Michi-Tsubaki/ping-pong-robot/docs/report/presentation/slide.pdf

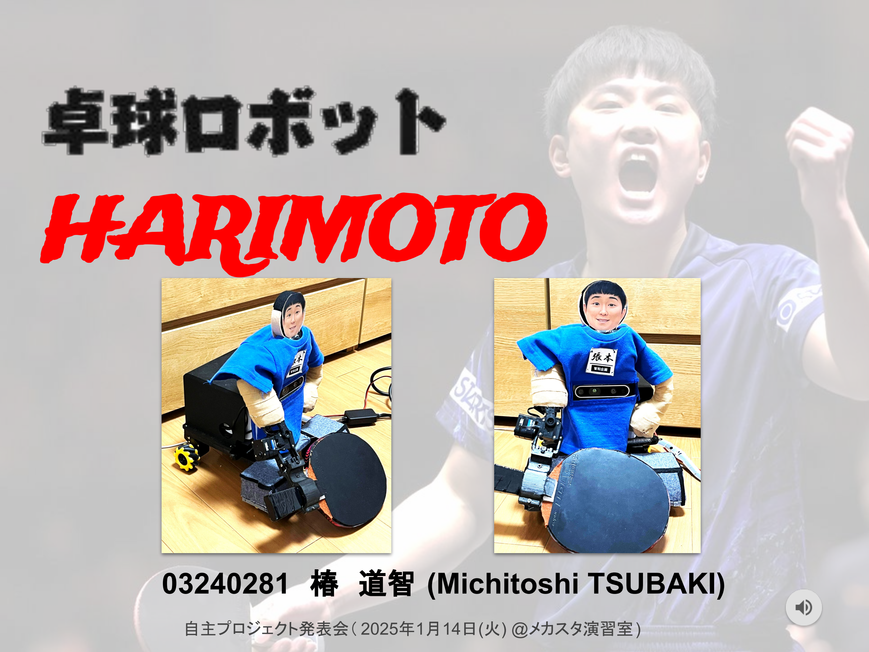
[picture p1: page 1]

# 03240281 椿 道智 (Michitoshi TSUBAKI)

自主プロジェクト発表会（ 2025年1月14日(火) @メカスタ演習室)

# HARIMOTO

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

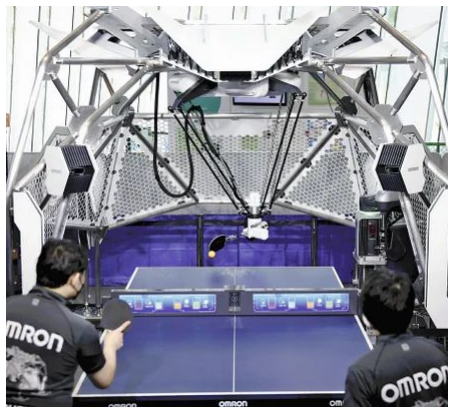
[picture p2: figure]
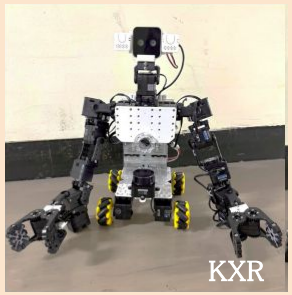
[picture p3: figure]
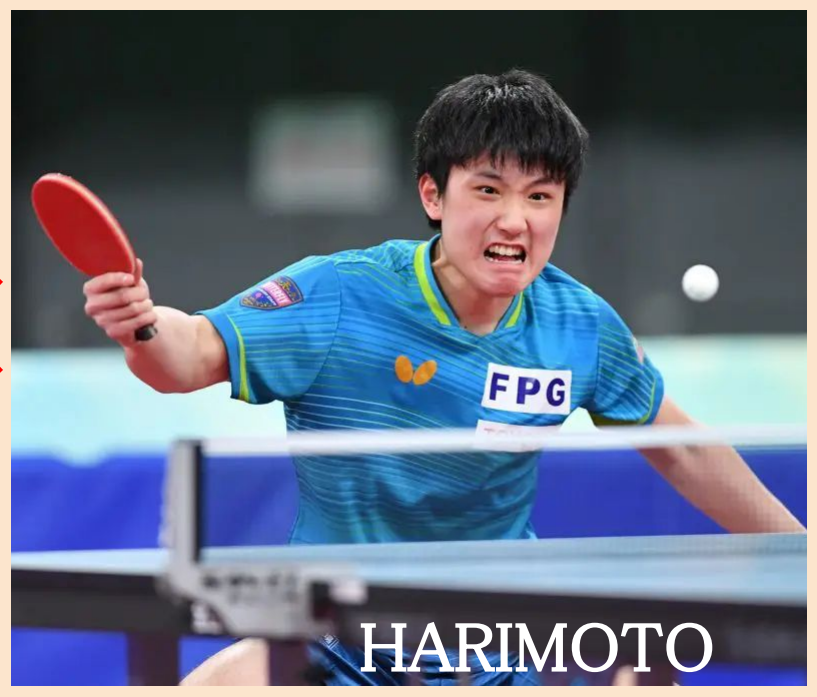
[picture p4: figure]

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

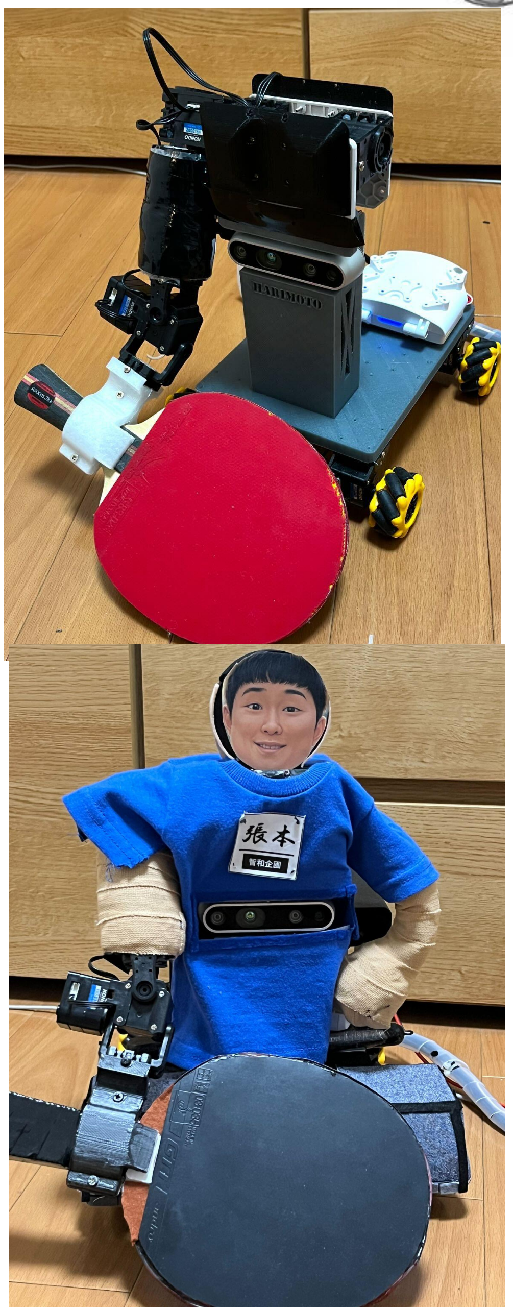
[picture p5: figure]

# システム構成図

# 画像処理

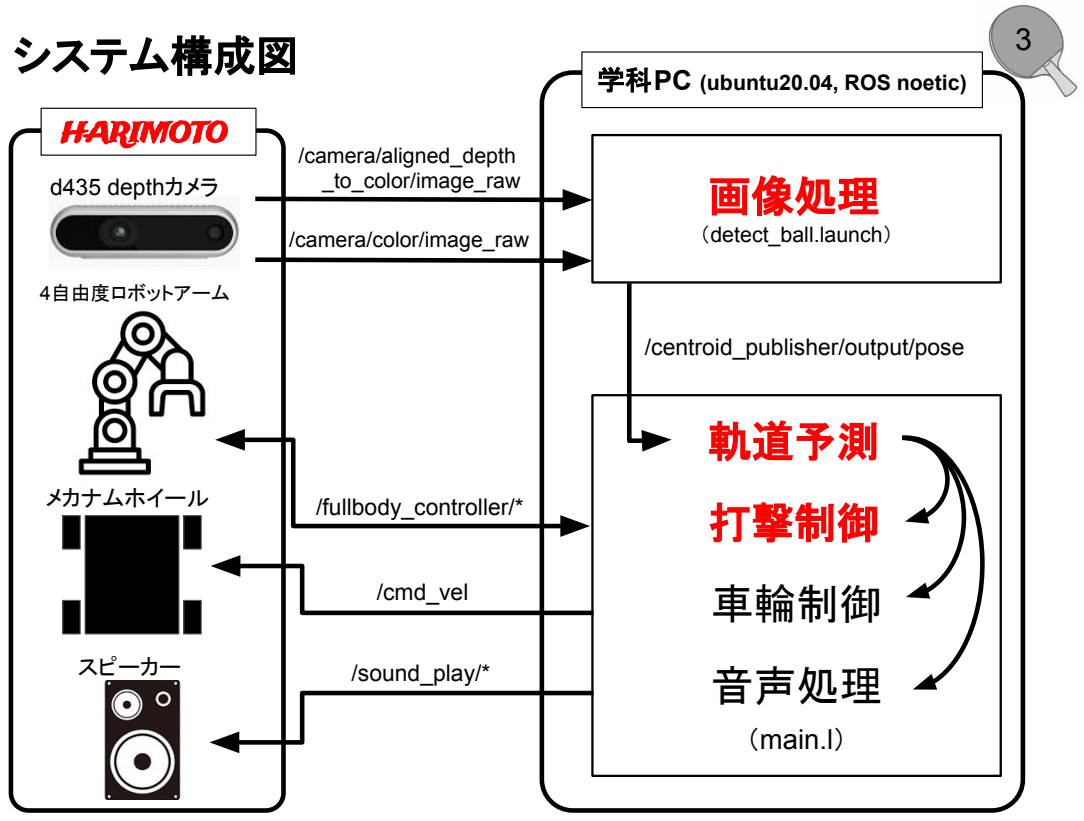
[picture p6: page 4]
（detect_ball.launch）; 軌道予測; 打撃制御; 車輪制御; 音声処理; （main.l）; d435 depthカメラ; /centroid_publisher/output/pose; スピーカー; メカナムホイール; 4自由度ロボットアーム; /cmd_vel; HARIMOTO; /camera/color/image_raw; /camera/aligned_depth _to_color/image_raw; /sound_play/*; /fullbody_controller/*

学科PC (ubuntu20.04, ROS noetic)

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
