Michi-Tsubaki/ping-pong-robot/model/figure/arm_1.png

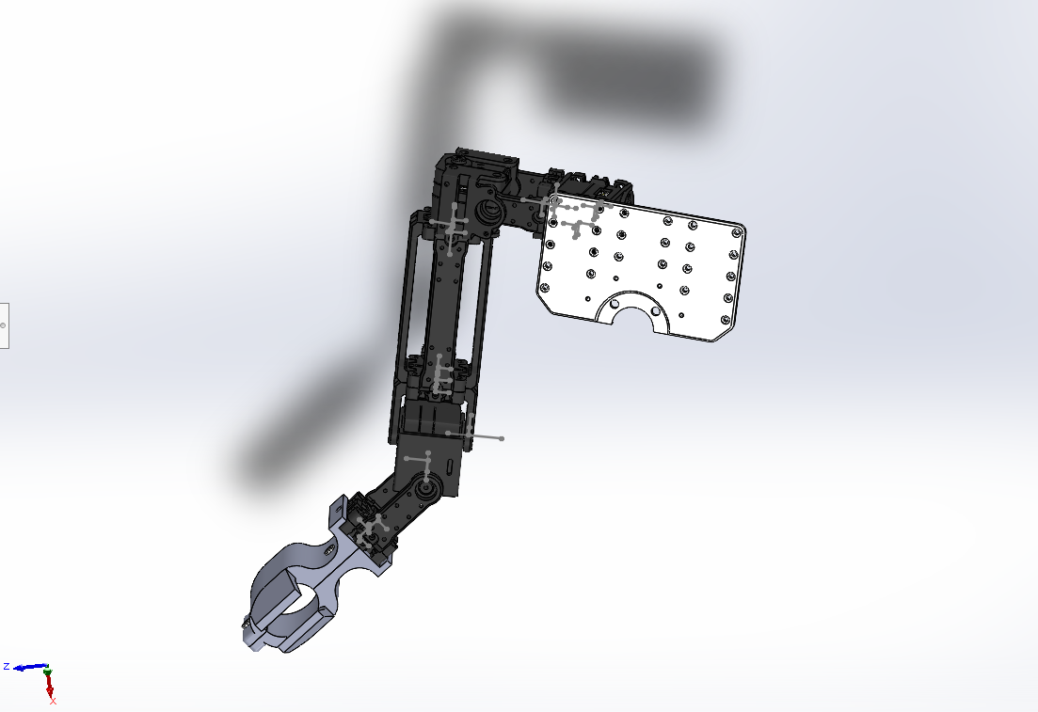
model/figure/arm_1.png
