Michi-Tsubaki/ping-pong-robot/model/figure/arm_skelton_1.png

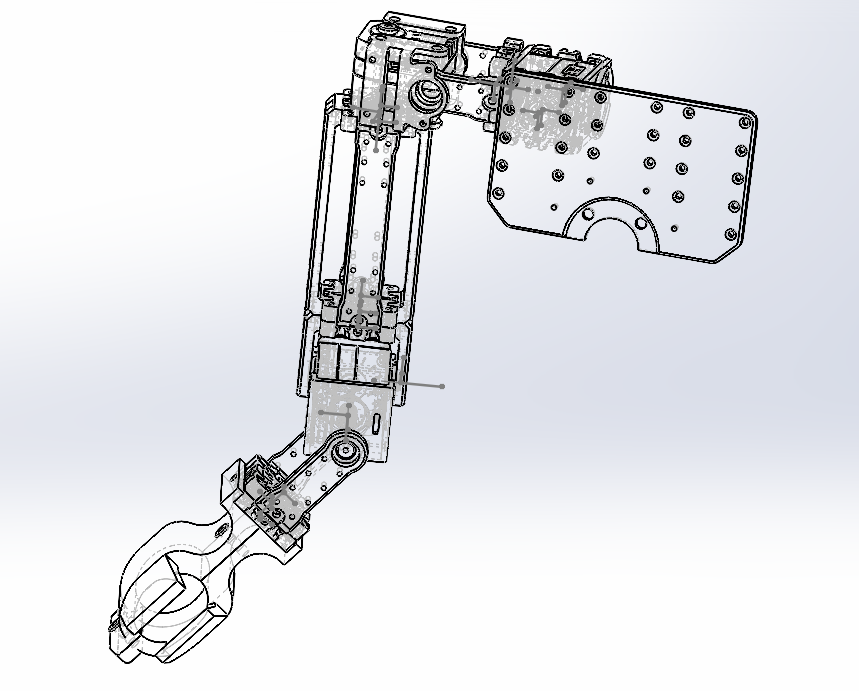
model/figure/arm_skelton_1.png
