Michi-Tsubaki/ping-pong-robot/model/assembly/base.SLDASM

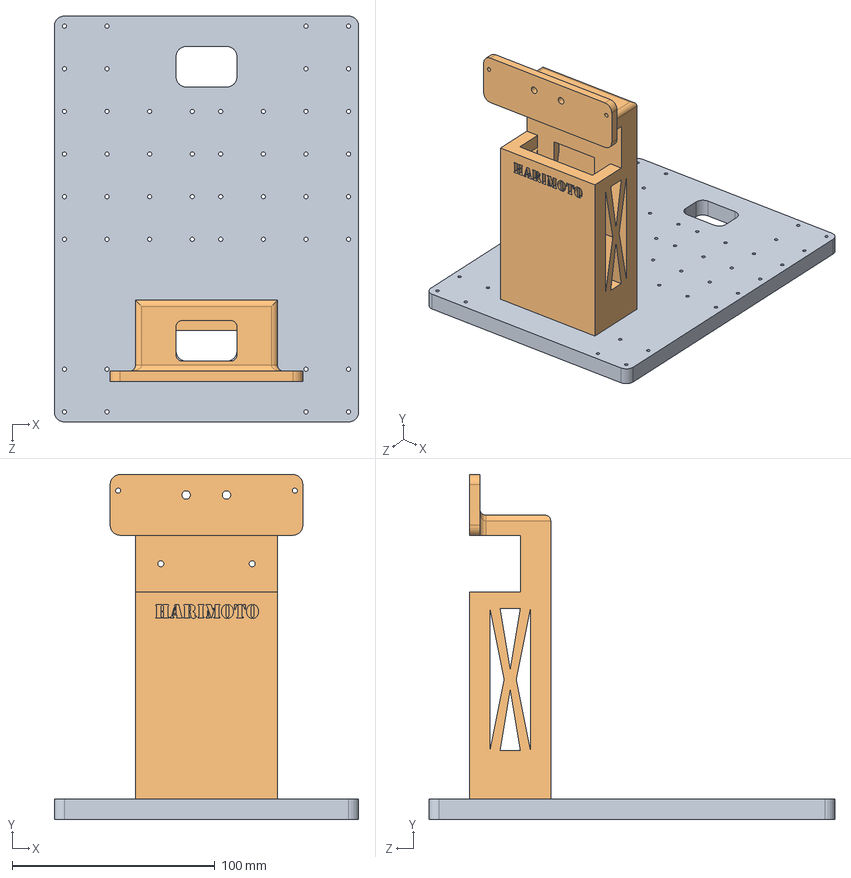
[picture p18: CAD file, 2025-05-12]
model/assembly/base.SLDASM
150.0 x 170.0 x 200.0 mm
body_base
wheel_base
