Michi-Tsubaki/ping-pong-robot/meshes/lower_shoulder.STL

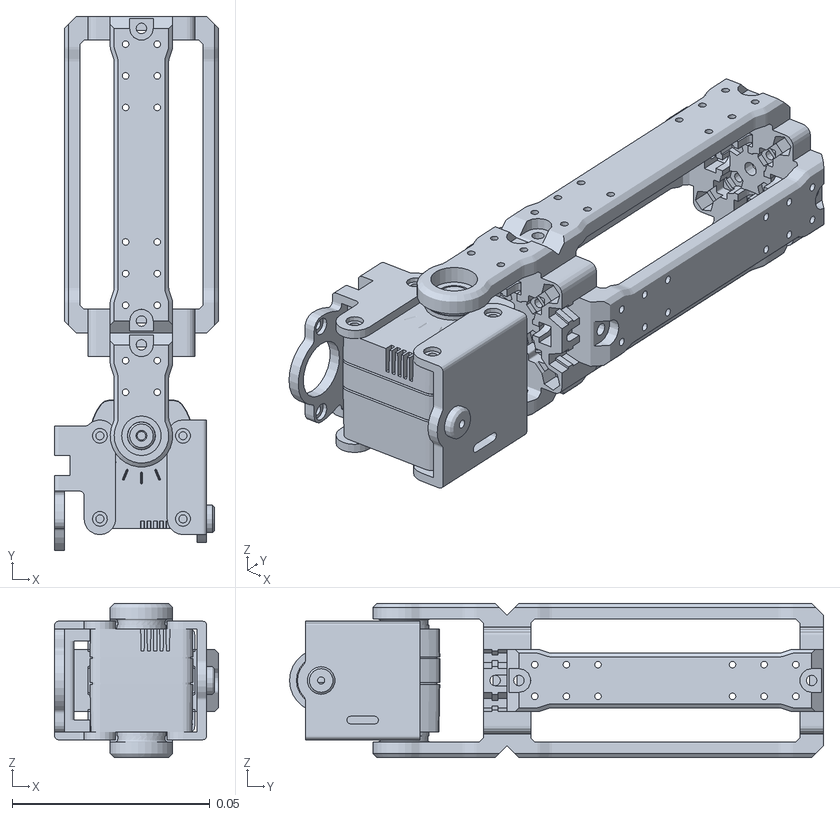
[picture p19: CAD file, 2025-05-12]
meshes/lower_shoulder.STL
0.0415 x 0.135 x 0.039
