Michi-Tsubaki/ping-pong-robot/model/figure/body_panel_cut3.DXF

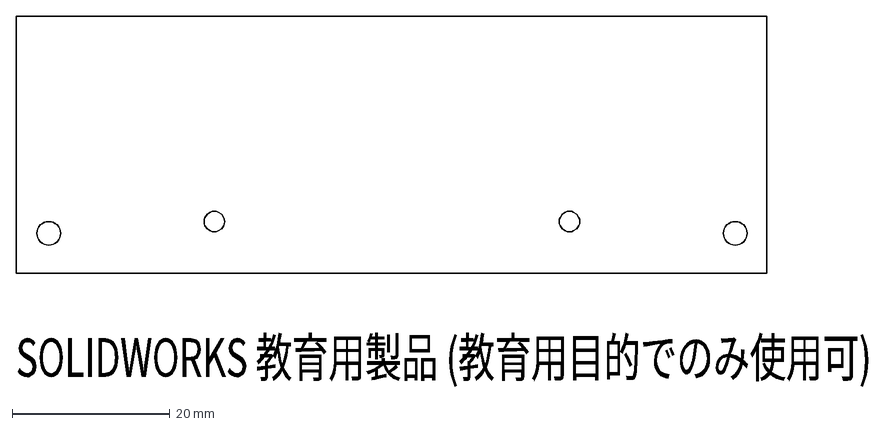
[picture p20: CAD file, 2025-05-12]
model/figure/body_panel_cut3.DXF
SOLIDWORKS 教育用製品 (教育用目的でのみ使用可)
