Michi-Tsubaki/ping-pong-robot/model/parts/sldprt/wheel_base.SLDPRT

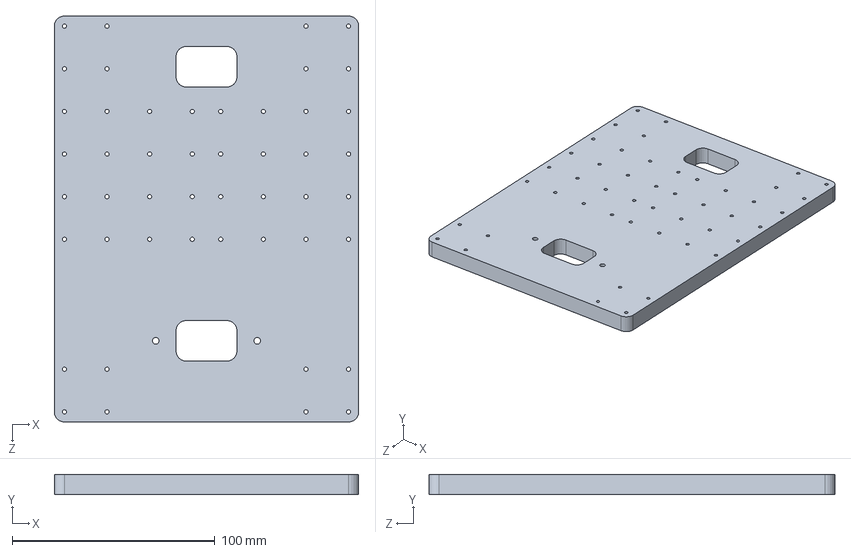
[picture p21: CAD file, 2025-05-12]
model/parts/sldprt/wheel_base.SLDPRT
150.0 x 10.0 x 200.0 mm
