Michi-Tsubaki/ping-pong-robot/model/parts/stl/body_panel_cut3.STL

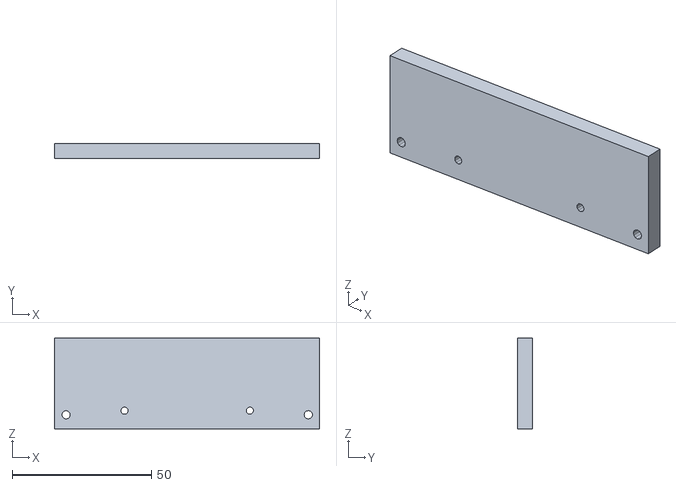
[picture p22: CAD file, 2025-05-12]
model/parts/stl/body_panel_cut3.STL
95.1 x 5.50 x 32.6
