Michi-Tsubaki/ping-pong-robot/meshes/larm_link7.stl

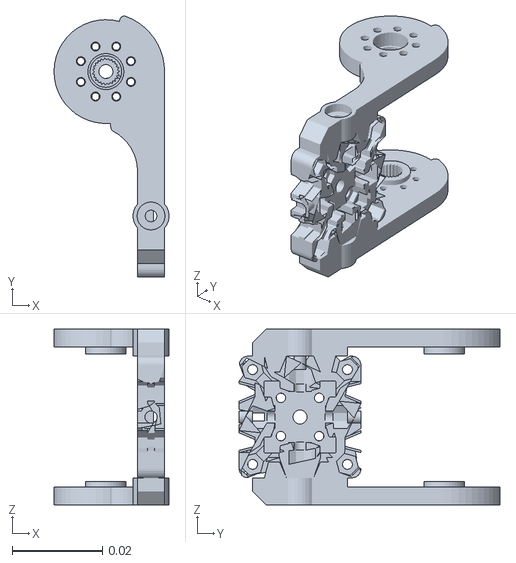
[picture p23: CAD file, 2025-05-12]
meshes/larm_link7.stl
0.0255 x 0.0578 x 0.039
