Michi-Tsubaki/ping-pong-robot/model/parts/sldprt/racket_holeder_2.SLDPRT

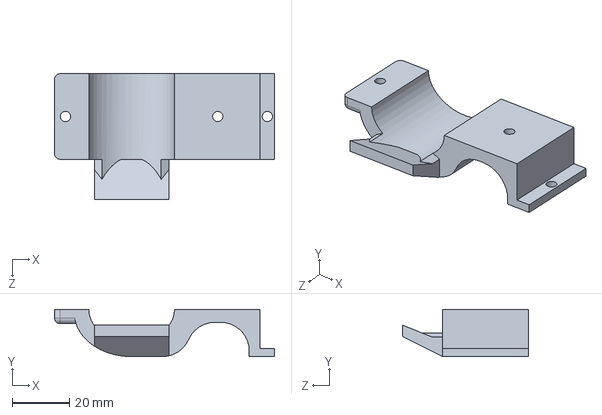
[picture p24: CAD file, 2025-05-12]
model/parts/sldprt/racket_holeder_2.SLDPRT
77.0 x 16.5 x 44.0 mm
