Michi-Tsubaki/ping-pong-robot/model/parts/stl/case.STL

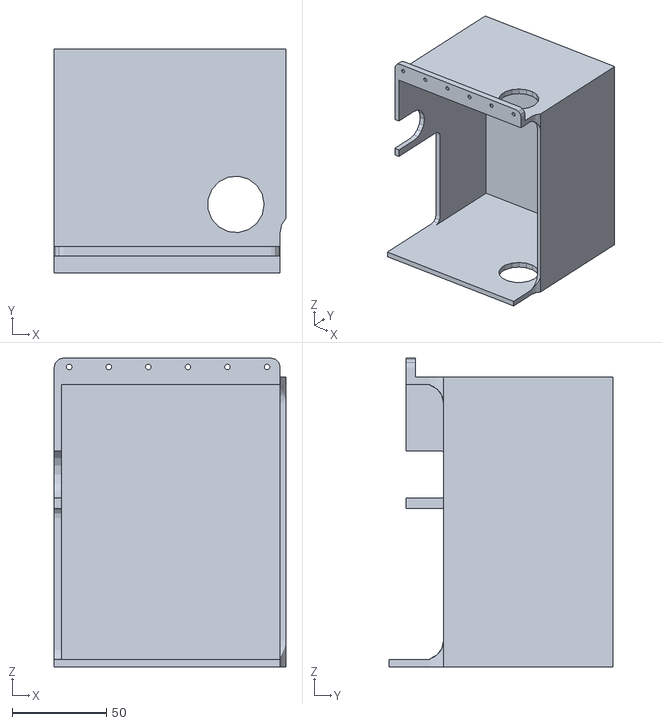
[picture p25: CAD file, 2025-05-12]
model/parts/stl/case.STL
123.0 x 119.0 x 164.0
