Michi-Tsubaki/ping-pong-robot/meshes/rear_right_wheel_link.stl

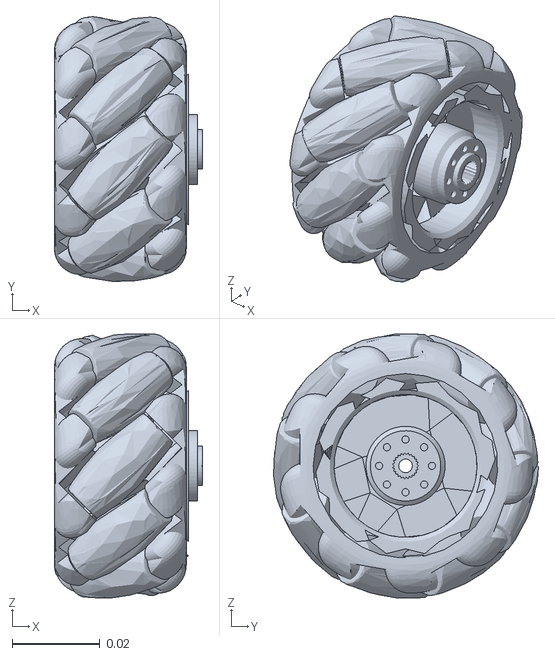
[picture p26: CAD file, 2025-05-12]
meshes/rear_right_wheel_link.stl
0.0337 x 0.0603 x 0.0601
