Michi-Tsubaki/ping-pong-robot/model/parts/stl/Generic Human Head.STL

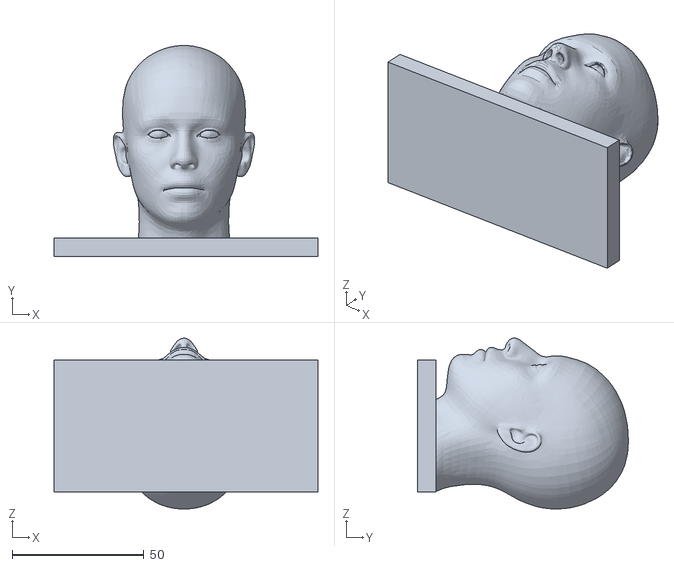
[picture p27: CAD file, 2025-05-12]
model/parts/stl/Generic Human Head.STL
100.0 x 79.9 x 64.7
