Michi-Tsubaki/ping-pong-robot/meshes/larm_link6.stl

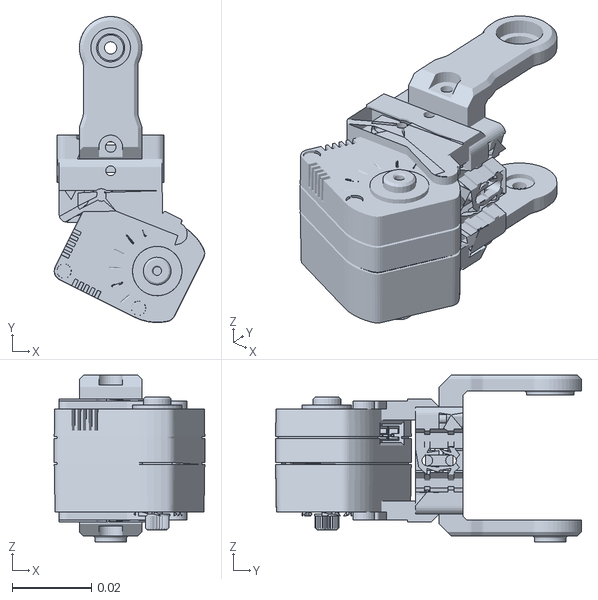
[picture p28: CAD file, 2025-05-12]
meshes/larm_link6.stl
0.038 x 0.0772 x 0.042
