Michi-Tsubaki/ping-pong-robot/model/parts/sldprt/body_base.SLDPRT

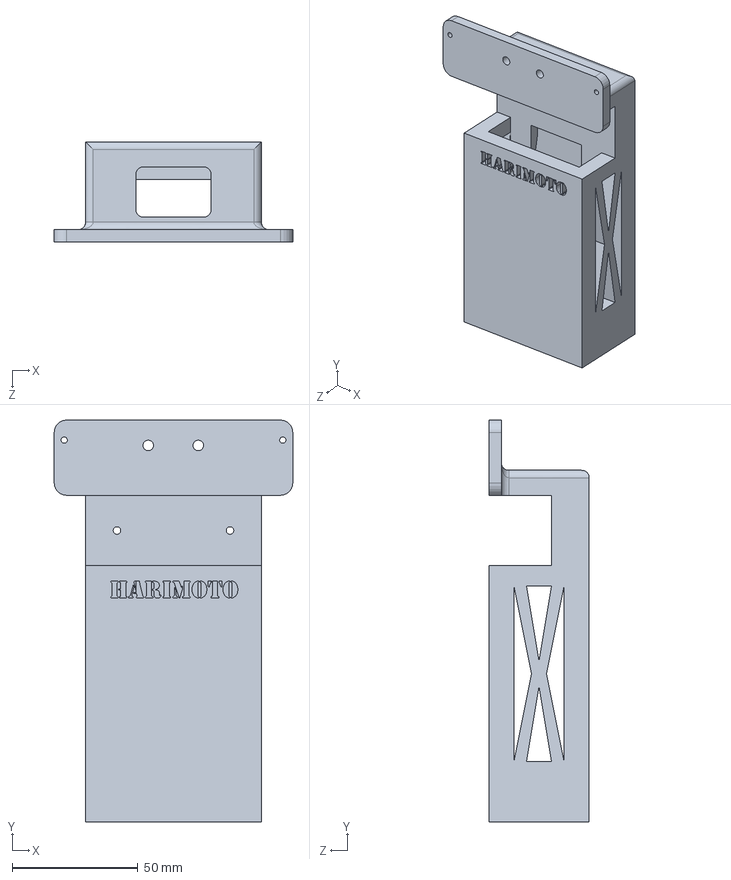
[picture p29: CAD file, 2025-05-12]
model/parts/sldprt/body_base.SLDPRT
95.0 x 160.0 x 40.0 mm
