Michi-Tsubaki/ping-pong-robot/meshes/head_link0.stl

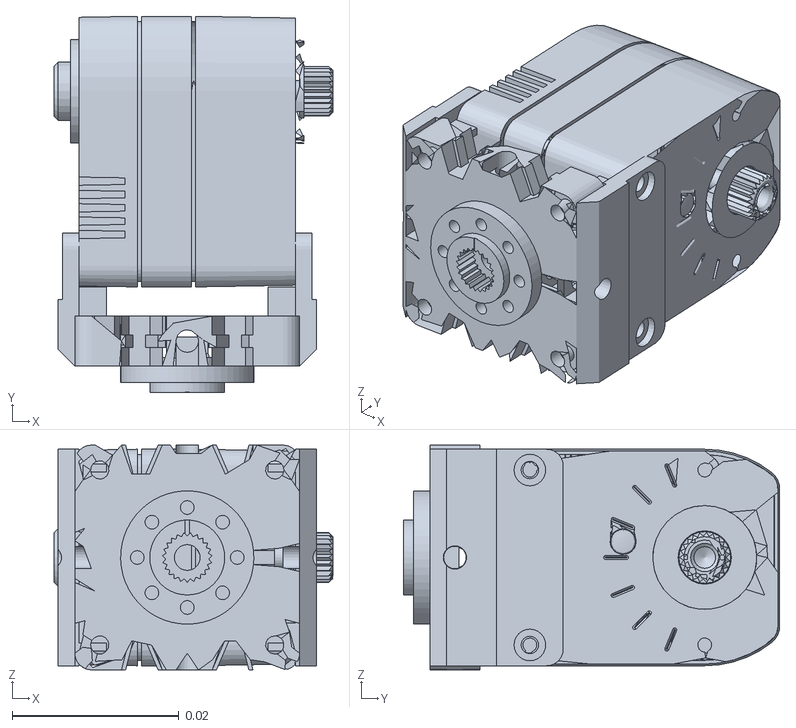
[picture p30: CAD file, 2025-05-12]
meshes/head_link0.stl
0.0335 x 0.0452 x 0.027
