Michi-Tsubaki/ping-pong-robot/model/parts/sldprt/arm_long.SLDPRT

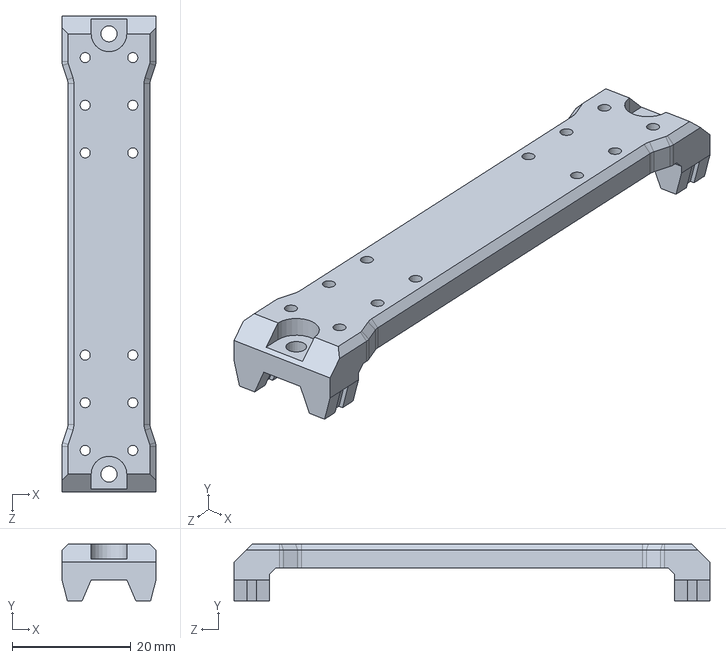
[picture p31: CAD file, 2025-05-12]
model/parts/sldprt/arm_long.SLDPRT
15.8 x 9.50 x 80.0 mm
