Michi-Tsubaki/ping-pong-robot/model/parts/stl/motor.STL

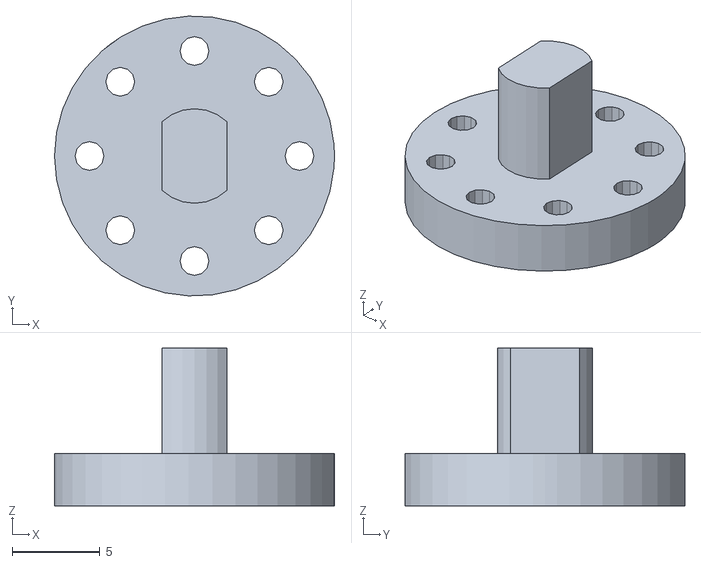
[picture p32: CAD file, 2025-05-12]
model/parts/stl/motor.STL
16.0 x 16.0 x 9.00
