Michi-Tsubaki/ping-pong-robot/meshes/base_link.STL

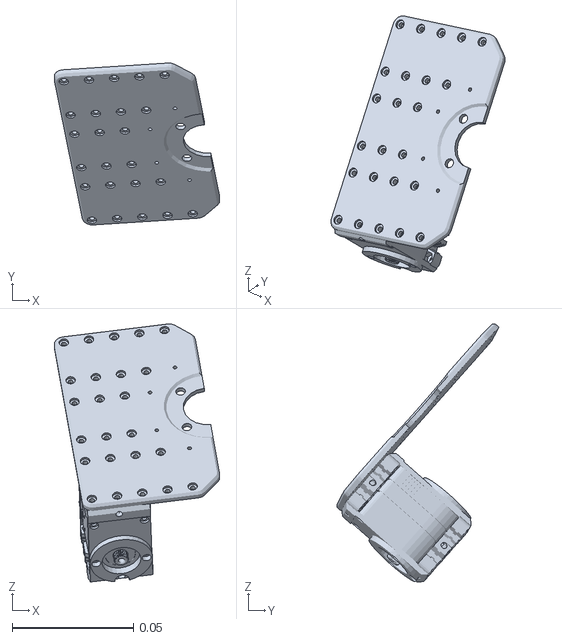
[picture p33: CAD file, 2025-05-12]
meshes/base_link.STL
0.0683 x 0.0668 x 0.106
