Michi-Tsubaki/ping-pong-robot/meshes/lower_arm.STL

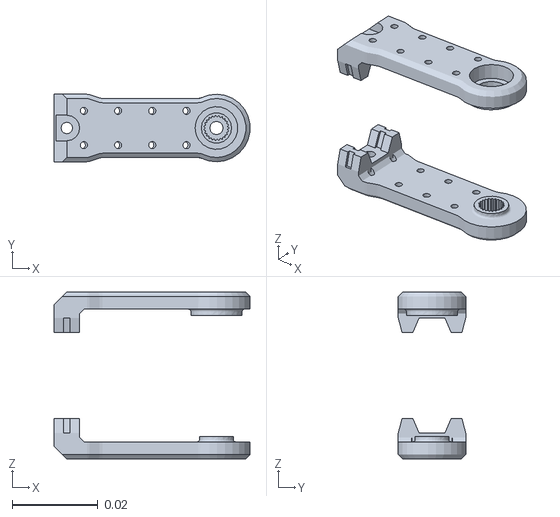
[picture p34: CAD file, 2025-05-12]
meshes/lower_arm.STL
0.0458 x 0.0158 x 0.039
