Michi-Tsubaki/ping-pong-robot/meshes/rarm_link4.stl

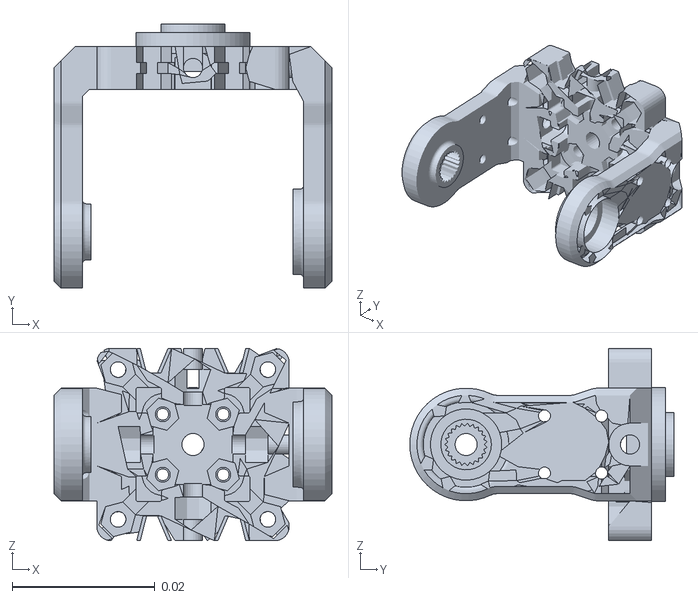
[picture p35: CAD file, 2025-05-12]
meshes/rarm_link4.stl
0.039 x 0.0371 x 0.027
