Michi-Tsubaki/ping-pong-robot/meshes/larm_link3.stl

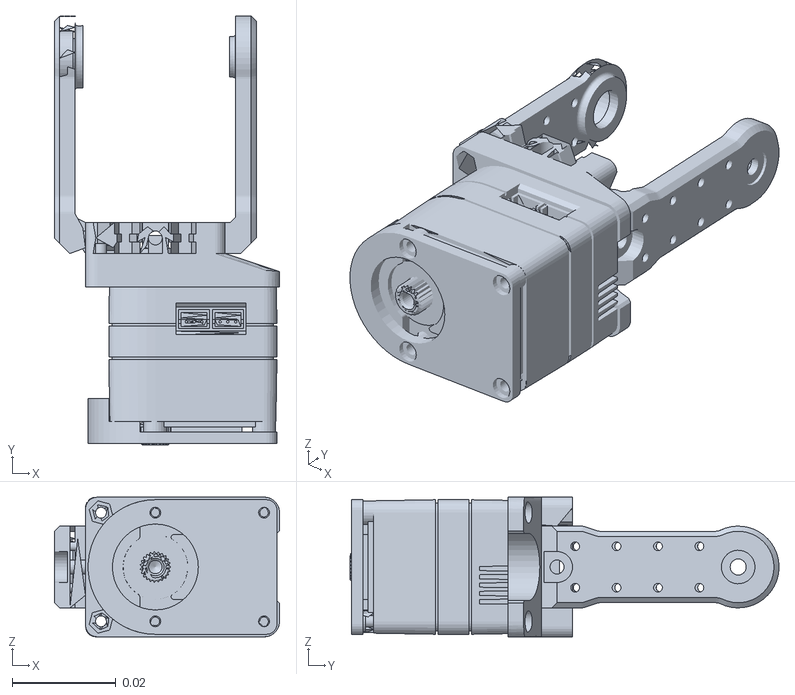
[picture p36: CAD file, 2025-05-12]
meshes/larm_link3.stl
0.0435 x 0.0829 x 0.027
