Michi-Tsubaki/ping-pong-robot/meshes/rarm_link0.stl

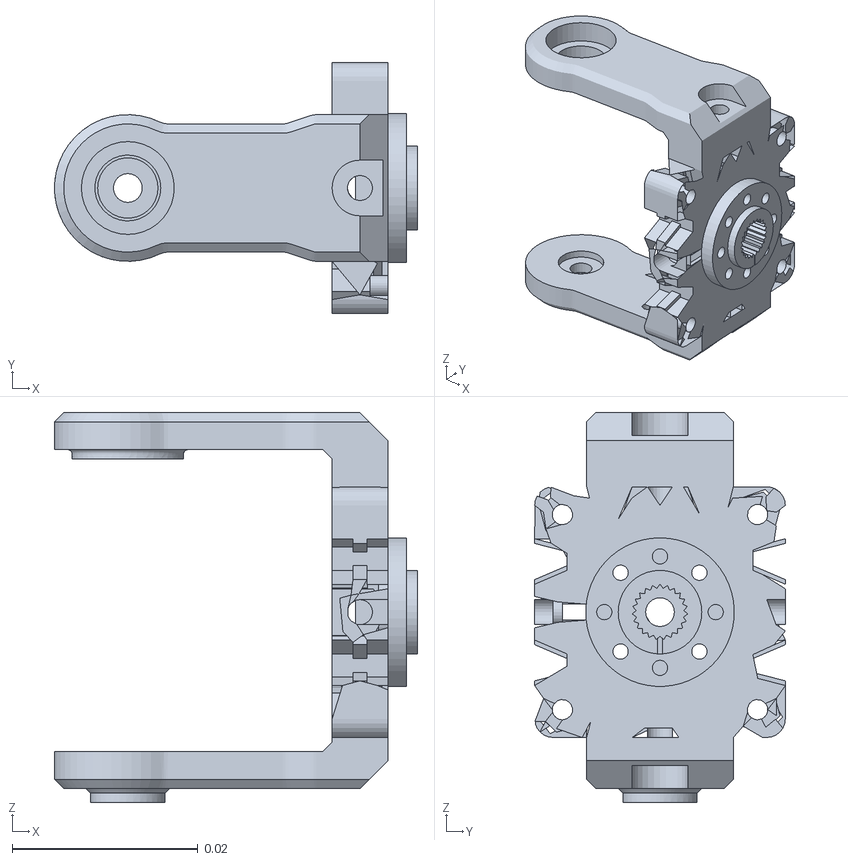
[picture p37: CAD file, 2025-05-12]
meshes/rarm_link0.stl
0.0391 x 0.027 x 0.042
