Michi-Tsubaki/ping-pong-robot/meshes/head_link1.stl

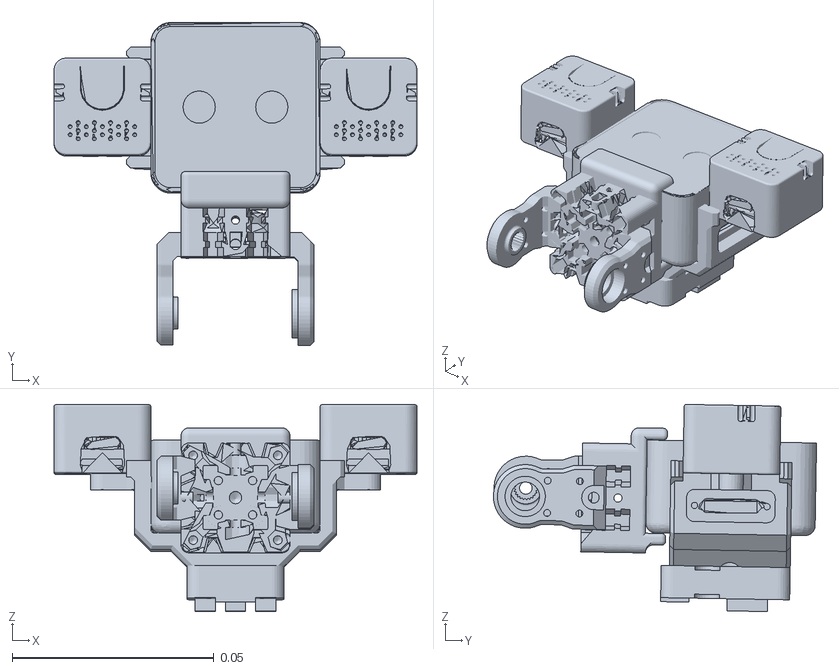
[picture p38: CAD file, 2025-05-12]
meshes/head_link1.stl
0.09 x 0.0801 x 0.0514
