Michi-Tsubaki/ping-pong-robot/meshes/rarm_link1.stl

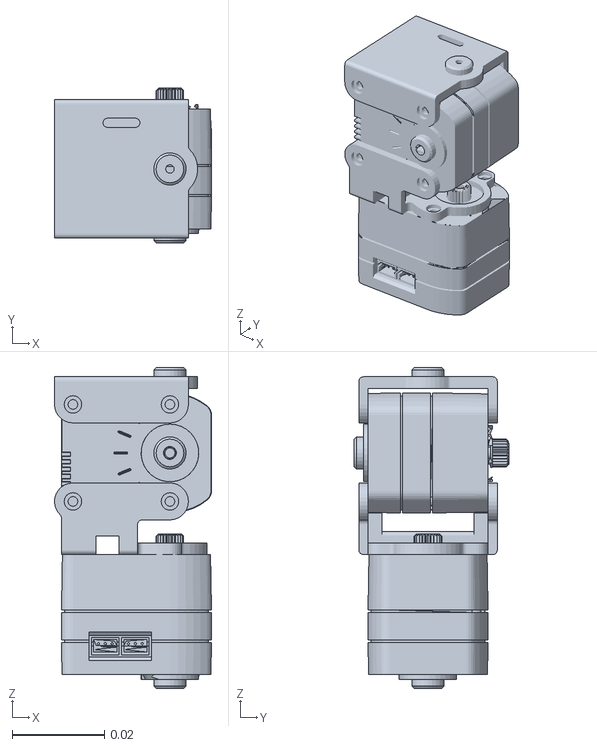
[picture p39: CAD file, 2025-05-12]
meshes/rarm_link1.stl
0.034 x 0.0335 x 0.0695
