Michi-Tsubaki/ping-pong-robot/meshes/hand.STL

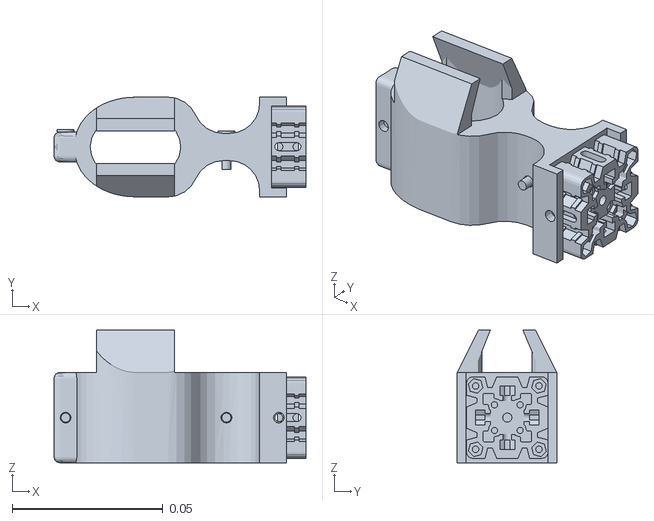
[picture p40: CAD file, 2025-05-12]
meshes/hand.STL
0.0835 x 0.033 x 0.044
