Michi-Tsubaki/ping-pong-robot/meshes/upper_shoulder.STL

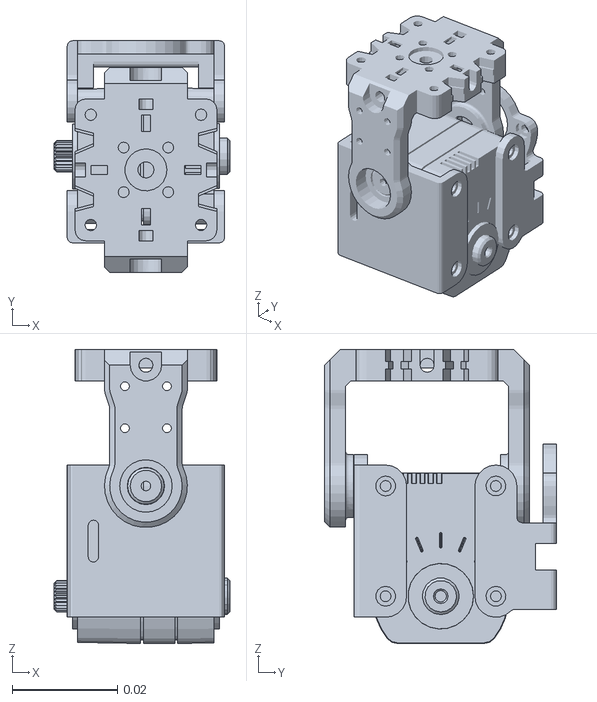
[picture p41: CAD file, 2025-05-12]
meshes/upper_shoulder.STL
0.0335 x 0.0441 x 0.056
