Michi-Tsubaki/ping-pong-robot/meshes/upper_arm.STL

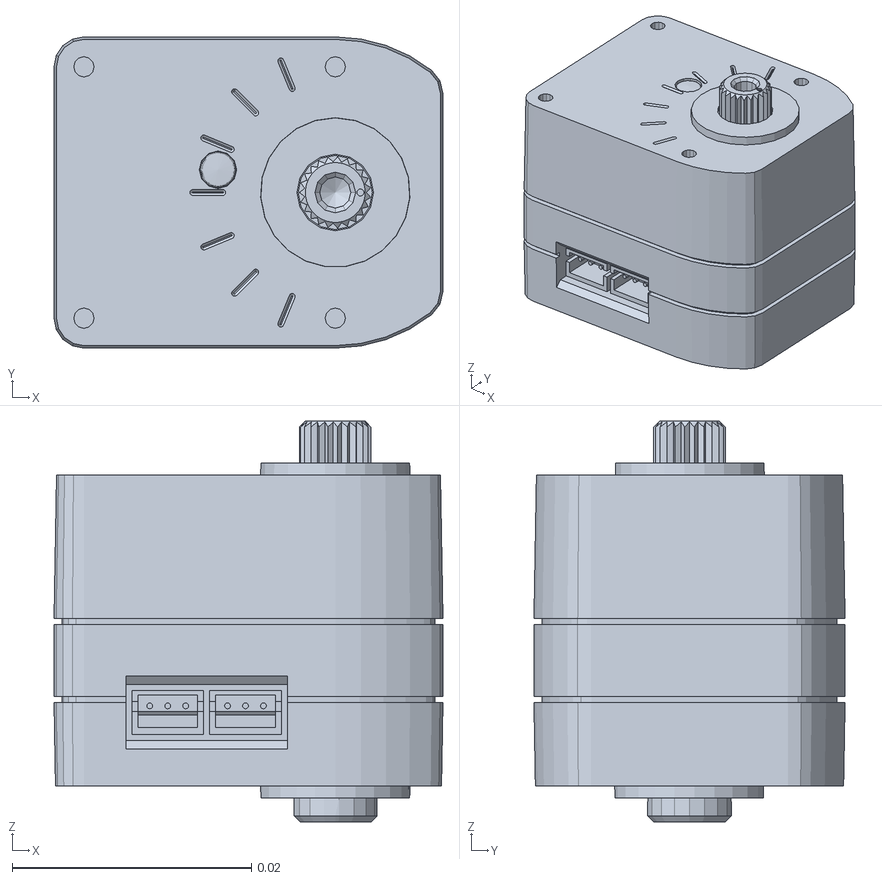
[picture p42: CAD file, 2025-05-12]
meshes/upper_arm.STL
0.0325 x 0.026 x 0.0335
