Michi-Tsubaki/ping-pong-robot/meshes/larm_link5.stl

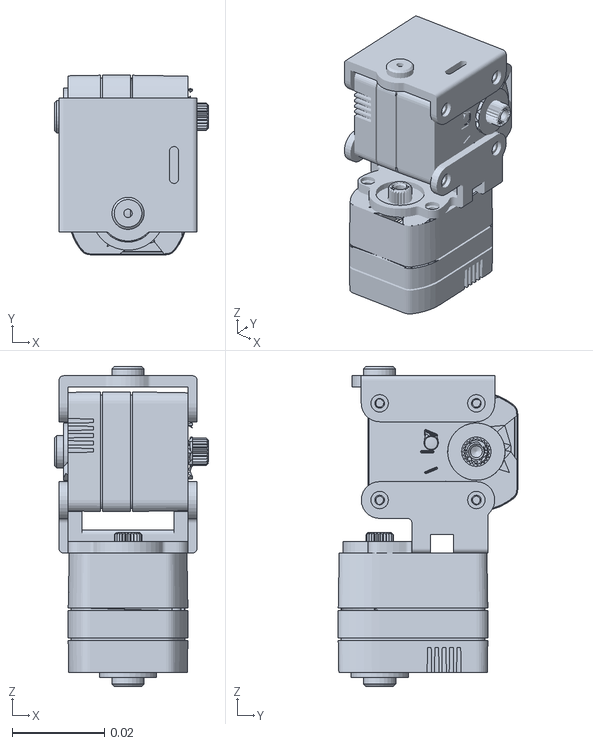
[picture p43: CAD file, 2025-05-12]
meshes/larm_link5.stl
0.0335 x 0.039 x 0.0695
