Michi-Tsubaki/ping-pong-robot/(list of files, cad)

Other CAD files:
model/parts/sldprt/box.SLDPRT
model/parts/stl/ping-pong.STL
model/parts/sldprt/racket_holeder_1.SLDPRT
meshes/rarm_link7.stl
meshes/rarm_link2.stl
meshes/rarm_link8.stl
meshes/larm_link2.stl
meshes/rarm_link3.stl
meshes/rarm_link6.stl
meshes/larm_link8.stl
meshes/larm_link1.stl
meshes/front_left_wheel_link.stl
meshes/larm_link0.stl
meshes/rear_left_wheel_link.stl
meshes/larm_link4.stl
meshes/front_right_wheel_link.stl
meshes/rarm_link5.stl
model/parts/stl/body_base.STL
model/parts/stl/wheel_base.STL
