Michi-Tsubaki/ping-pong-robot/(threads)

Thread 1 (2024-11-27):

PR2, jedyで卓球の動きを試してみる

Michi-Tsubaki, 2024-11-27:
# PR2でやってみた
PR2で(たぶん)一番簡易的に卓球の動きをしてみたコード`(send *ri* :state :potentio-vector `をコピっただけ。
https://github.com/Michi-Tsubaki/jsk_demos/blob/jsk_2024_10_semi/jsk_2024_10_semi/pingpong-sample/pingpong.l

## バックハンドだとこんな感じ

### 動画1
https://github.com/user-attachments/assets/0afa855d-5f32-442b-870e-849f0804b06d

### 動画2
https://github.com/user-attachments/assets/229bdfd1-319f-4990-8b08-95c3cb5de83e

## 思ったこと
・うまい補完が大事．そのために点数が多いほうがいい（3つは少なすぎた）
・自分で軌跡を作ってIK解いた方がいいかも．

Michi-Tsubaki, 2024-11-28:
# jedyでやってみた
PR2の実験で3点では上手く補間できなかったので5点くらいに点数を増やしてみた．
## バックハンドツッツキ
### 動画

https://github.com/user-attachments/assets/58af0d7e-ff3f-47bb-b5d5-2a6d98f768b1

### コード
https://github.com/Michi-Tsubaki/ping-pong-robot/blob/c99035263915bffc388f7ff938156fd1baa74838/sample_robot/jedy/demo-jedy-back-push.l

### コメント
ツッツキは良さげじゃないか！

## バックハンドドライブ
### 動画

https://github.com/user-attachments/assets/d8eadfb0-0880-41b4-89dd-725a9e457ba0

### コード
https://github.com/Michi-Tsubaki/ping-pong-robot/blob/c99035263915bffc388f7ff938156fd1baa74838/sample_robot/jedy/demo-jedy-back-drive.l

### コメント
アームの可動空間の制約でangle-vectorを取るのが難しかった．改善の余地しかない．

## フォアハンドドライブ

Closed 2024-12-07.

Thread 2 (2024-12-03):

システム構成図を描いた．

Michi-Tsubaki, 2024-12-03:
システム構成図をUMLで記述した
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

source code: https://github.com/Michi-Tsubaki/ping-pong-robot/blob/4b289889bf2d1689ced3243fcdbe22f4aa74b7f2/document/uml1.act
viewer: https://www.plantuml.com
output: https://x.gd/Btlls

Michi-Tsubaki, 2024-12-06:
一番初めの打ち合わせの時のメモ(黒字)

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

Closed 2024-12-07.

Thread 3 (2024-12-03):

Armの自作パーツの設計とアセンブリをした

Michi-Tsubaki, 2024-12-03:
Solid Worksのキャプチャ
https://github.com/Michi-Tsubaki/ping-pong-robot/blob/3c2c44de142a88e35b4ec93cbe4067af3724c6c7/model/figure/arm_1.png
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

https://github.com/Michi-Tsubaki/ping-pong-robot/blob/3c2c44de142a88e35b4ec93cbe4067af3724c6c7/model/figure/arm_skelton_1.png
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

Michi-Tsubaki, 2024-12-03:
アセンブリ: https://github.com/Michi-Tsubaki/ping-pong-robot/blob/11fff3002181b4bc925a64497ec63f6cfc128cd6/model/assembly/arm.SLDASM

自作パーツ: https://github.com/Michi-Tsubaki/ping-pong-robot/tree/main/model/parts

Michi-Tsubaki, 2024-12-06:
アーム組み立て完了

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

Michi-Tsubaki, 2024-12-06:
ちなみに、このurdf visualiserが使えなかった。

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

Closed 2024-12-10.

Thread 4 (2024-12-07):

URDFを作ってから自作のアームを動かすまで

Michi-Tsubaki, 2024-12-07:
URDFを作り終わった→eusで(send *ri * :angle-vector)してロボットを動かす方法
###  ①kxr_control, kxr_eus, kxr_modelをworkspaceで使えるようにする．(riで必要)
```
cd ~/ros/enshu_ws/src
cp rcb4 <jishupro_ws>/src/
cd <path to jushupro_ws>
catkin clean
catkin build
```
＊~/ros/enshu_wsを削除してしまった場合は，robot-programmingの資料@utolを確認．ただ，
```
cd <path to jushupro_ws>/src
git submodule add https://github.com/iory/rcb4.git
cd ..
catkin clean
catkin build
```
のほうが本当は良さそうだから，enshu_wsからコピペする必要ないかも．
### ②.urdf -> .lに変換
```
cd <path to jushupro_ws>
source devel/setup.bash
roscd <path to robot_pkg>
cd urdf
pip install urdfeus -U --no-cache-dir
urdf2eus <path to .urdf file> <path to output path of .l file>
```
### ③script directoryを作る
```
source <jshupro_ws path>/devel/setup.bash
roscd <path to robot_pkg>
mkdir scripts
```
### ④robot_servo_config.yamlを作る
```
source <jshupro_ws path>/devel/setup.bash
roscd <path to robot_pkg>/config
emacs robot_servo_config.yaml
```
参考: https://github.com/Michi-Tsubaki/ping-pong-robot/tree/main/src/HARIMOTO/config/HARIMOTO_servo_config.yaml
を自分のロボットのjoint nameとservo idに書き換えればよい．
### ⑤minimal.launchを作る
```
roscd <path to robot_pkg>/launch
emacs minimal.launch
```
参考: https://gist.github.com/Michi-Tsubaki/8c4b0e42a462720378095abf3b6ece6e
の上2行
```
  <arg name="urdf_path" default="$(find HARIMOTO)/urdf/HARIMOTO.urdf" />
  <arg name="servo_config_path" default="$(find HARIMOTO)/config/HARIMOTO_servo_config.yaml" />
```
を自分のpathに書き換えればよい．
### ⑥scriptsにscan_ids.pyを作って実行する．
まず，servoとPCを接続音がなってからUSBを挿す．
```
source <jshupro_ws path>/devel/setup.bash
roscd <path to robot_pkg>
cd scripts
emacs scan_ids.py
******scan_ids.pyを作成後Ctrl+s, Ctrl+cで保存******
python3 scan_ids.py
```
して，https://github.com/iory/robot-programming/blob/jedy/jedy/jedy_bringup/scripts/scan_ids.py
の13行目package = 'jedy_description'
30行目の
```
config_path = osp.join(
    rospackage_path,
    'config',
    'jedy_servo_config.yaml'
)
```
あたりを書き換える．
これでまず，すべてのサーボが読み込めているか確認．
### ⑦(scriptsに(である必要はない))robot-interface.lを作る
```
roscd <path to robot_pkg>
cd scripts
emacs <robot name>-interface.l
******作成後Ctrl+s, Ctrl+cで保存******
```
https://github.com/iory/robot-programming/blob/jedy/jedy/jedy_bringup/euslisp/jedy-interface.l
https://github.com/Michi-Tsubaki/ping-pong-robot/blob/main/src/HARIMOTO/scripts/HARIMOTO-interface.l
あたりを参考に，<robot name>の書き換えやその他パスの変更を行う．必要ないメンバ関数は削除．
### ⑧scriptsにサンプルコードを作ってロード
```
source <jshupro_ws path>/devel/setup.bash
roscd <path to robot_pkg>
cd scripts
emacs demo.l
******作成後Ctrl+s, Ctrl+cで保存******
```
- USBでサーボに接続していることを確認
- minimal.launchを立ち上げ
```
source <jshupro_ws path>/devel/setup.bash
roscd <path to robot_pkg>/launch
roslaunch minimal.launch
```
サーボを実際に動かす（私の場合はフォアドライブのコード）
- 別のターミナルで
```
source <jshupro_ws path>/devel/setup.bash
roseus
load "demo.l"
```
で動くはず．
参考サンプルコード：https://gist.github.com/Michi-Tsubaki/863ccb3efd933d67cd45db2543dc0a5e
他にも
`(send * ri* :state :angle-vector) `でサーボのpotentioメータの角度を調べるなどできる．
（注記）私のアームは4自由度でIKが解けないのでend-coordsのyamlの作成はシなかった．

Michi-Tsubaki, 2024-12-07:
バックドライブのデモ

https://github.com/user-attachments/assets/95fc8d3a-8c44-4a7c-a298-ded0fc988b6c

Michi-Tsubaki, 2024-12-07:
（自分用メモ　サーボのmin max (degree) ）

```
id 0  min -70 max 0

id 2 min -135 max 45

id 4 min -40 max  40

id 6 min -80 max 80
```

Michi-Tsubaki, 2024-12-10:
ひとまずこのissueは完了したかな．

Closed 2024-12-10.

Thread 5 (2024-12-10):

バックハンドによる基礎打ち動作関数を作る

Michi-Tsubaki, 2024-12-10:
## 考えられる方法
- 運動学(自由度足りない)→ok以外(擬似逆行列)
- モデルベース

## その他
- 引数(動作時間とかも？)
- 動作の種類

Michi-Tsubaki, 2024-12-11:
基礎位置をするために，アームを固定する仮の胴体を作った。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

Michi-Tsubaki, 2024-12-14:
https://github.com/user-attachments/assets/3941d3df-5fae-4ac1-bcb1-fbf3b94a59c2

Michi-Tsubaki, 2024-12-20:
青サーボと赤サーボでスポードが変わるなら，サーボを変えたい.
サーボのスピードを決める変数はどこか調べる．ソフト的にもっと早くできるなら速くしたい．

Michi-Tsubaki, 2025-01-04:
基礎打ちを高さによって打ち分ける関数hitの完成！
```
(defun hit(x)
  ;;TODO: yとzを引数にしてもう少し複雑にする
  (setq r1 *basic-pose2*)
  (setq r2 (float-vector (- -110 (* 2 x)) (+ 100 x) -40 (+ 75 (* x 0.5))))
  (setq r3 (float-vector (- -110 (* 2 x)) (+ 110 x) -20  (+ 75 (* x 0.5))))
  (setq r4 (float-vector (- -120 (* 2 x)) (+ 100 x) 0 (+ 75 (* x 0.5))))
  (setq r5 (float-vector (- -120 (* 2 x)) (+ 80 x) 20 (+ 75 (* x 0.5))))
  (setq r6 (float-vector (- -120 (* 2 x)) (+ 50 x) 40 (+ 70 (* x 0.5))))
  (setq r7 *basic-pose2*)
  (setq tm 30)
  (send *ri* :angle-vector-sequence (list r1 r2 r3 r4 r5 r6 r7) (list tm tm tm tm tm tm 5000)
	:default-controller 0.0001
	:min-time 0.00001
	:minjerk-interpolation nil ;;trueにするとバグので注意
	)
  ;;(move-to 0.5 0)
  (send *ri* :send-cmd-vel-raw 1 0 0)
  (chorei)
  ;;(send *ri* :wait-interpolation)
  (send *irtviewer* :draw-objects)
  )
```

Closed 2025-01-04.

Thread 6 (2024-12-10):

Real Sense d435の動作確認　→　ボールのトラッキング

Michi-Tsubaki, 2024-12-10:
## 動作確認

```
git clone https://github.com/IntelRealSense/librealsense.git
cd librealsense/
sudo apt install -y git libssl-dev libusb-1.0-0-dev pkg-config libgtk-3-dev
sudo apt install -y libglfw3-dev libgl1-mesa-dev libglu1-mesa-dev
sudo apt install -y cmake
./scripts/setup_udev_rules.sh
./scripts/patch-realsense-ubuntu-lts.sh
mkdir build && cd build
cmake ../
sudo make clean && make && sudo make install
```
カメラのUSBをさしてPCにつないで[realsense-viewer](url)とコマンドを打って点群が見えればまずは大丈夫です。
次に自分のrosのworkspaceで以下をして
```
mkdir -p ~/realsense_ws/src/
cd ~/realsense_ws/src
git clone --depth 1  https://github.com/IntelRealSense/realsense-ros -b ros1-legacy
cd ~/realsense_ws
rosdep install --from-paths -i -y -r src
cd ~/realsense_ws
catkin b realsense2_camera --cmake-args -DCMAKE_BUILD_TYPE=Release
source ~/realsense_ws/devel/setup.bash
```
これが終わったら以下のlaunchを立ち上げるとcameraのトピックが見えると思います。
```
roslaunch realsense2_camera rs_rgbd.launch
```

## トラッキング
HSI_colorfilertを使いたい．
https://github.com/jsk-ros-pkg/jsk_recognition/blob/master/doc/jsk_pcl_ros/nodes/hsi_color_filter.md
を参考に

Michi-Tsubaki, 2024-12-10:
`realsense-viewer`
って打ったら
```
10/12 14:19:44,434 ERROR [140420992837504] (rs.cpp:237) [rs2_create_context_ex( api_version:25501, json_settings:{ ) UNKNOWN] failed to load configuration file (/home/mech-user/.realsense-config.json): [json.exception.parse_error.101] parse error at line 1, column 1: attempting to parse an empty input; check that your input string or stream contains the expected JSON
 10/12 14:19:44,435 ERROR [140420992837504] (rs.cpp:237) [rs2_delete_context( context:nullptr ) UNKNOWN] null pointer passed for argument "context"
 10/12 14:19:44,435 WARNING [140420992837504] (rs.cpp:274) null pointer passed for argument "context"
RealSense error calling rs2_create_context_ex(api_version:25501, json_settings:{):
    failed to load configuration file (/home/mech-user/.realsense-config.json): [json.exception.parse_error.101] parse error at line 1, column 1: attempting to parse an empty input; check that your input string or stream contains the expected JSON
```
と返ってきた．
`cat ~/.realsense-config.json`
したら，JSONの中身が空だったので，
```
cd ~
emacs .realsense-config.json
```
してJSONの中身を
```
{
    "settings": {}
}
```
にした，
　ここで，再び`realsense-viewer`って打ったら
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
点群がうまく表示された．

Michi-Tsubaki, 2024-12-10:
裏で
`roslaunch realsense2_camera rs_rgbd.launch`
を端末で立ち上げて，
別の端末で
`rosrun image_view image_view  image:=/camera/color/image_raw`
したところ，
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
しっかりtopic(/camera/color/image_raw)が見れた．また，
`rviz`でPointCloud2を表示させ，fixed_frameをcamera_linkに変更すると，
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
が確認できた．
参考：https://zenn.dev/naonaorange/articles/20181104_realsense_ros

Michi-Tsubaki, 2024-12-10:
Realsenseの処理で使うtopicの種類は https://matsuolab.github.io/roomba_hack_course/course/chap5/three-dimensions/ を参考に，ゼミで使ったlaunchファイルを書き換えて，HSIフィルタで赤色のみを抽出し，クラスタリングできるようにした．

右は `rostopic echo /detect_ball/cluster_decomposer/boxes` の結果(frame_idはcamera_link(カメラ座標)

rostopic echoがかくかくしていて，PCの？処理速度が遅い？

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

Michi-Tsubaki, 2024-12-12:
カメラ座標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

Michi-Tsubaki, 2024-12-12:
トラッキング結果が反映されない件について

https://github.com/Michi-Tsubaki/ping-pong-robot/issues/7

Michi-Tsubaki, 2024-12-14:
↑issueにより，ボールのトラッキング自体はうまくいっていたので本件は解決．

Closed 2024-12-14.

Thread 7 (2024-12-12):

ボールが指定した範囲に認識されても whileから抜け出せない

Michi-Tsubaki, 2024-12-12:
- ros:spin-once , ros:spin , ros:rate　系の問題
- while if  の使い方の問題
- )がどこか閉じていない

```
#!/usr/bin/env roseus

;;build node ping-pong
(ros::roseus "ping-pong")

;;load packages
(load "HARIMOTO-interface.l")
(ros::load-ros-package "jsk_recognition_msgs")

;;basic setting
(setq *ball-lost* t)

;;basic function
;;サーボ系
(defun on()
  (send *ri* :servo-on)
  )
(defun off()
  (send *ri* :servo-off)
  )
(defun wait-pose()
  (send *ri* :angle-vector #f(-70 28 -44 70) 5000)
  (send *ri* :wait-interpolation)
  (send *irtviewer* :draw-objects)
  )
(defun keep()
  (setq *tmp* (send *ri* :state :angle-vector))
  (send *ri* :angle-vector (send *ri* :state :angle-vector) 100)
  (send *ri* :wait-interpolation)
  (send *irtviewer* :draw-objects)
  (send *ri* :servo-on)
  )
;;認識系
(defun search-ball()
  (format t "search-ball~%")
  (ros::rate 10000)
  (ros::subscribe "/detect_ball/cluster_decomposer/boxes" jsk_recognition_msgs::BoundingBoxArray #'search-ball-cb)
  (ros::spin-once)
  )

(defun search-ball-cb(msg)
  (ros::ros-info "recog: ~A balls found!  ~%" (length (send msg :boxes)))
  (if (and (> (length (send msg :boxes)) 0) (> (send (send (elt (send msg :boxes) 0) :dimensions) :x) 0) )
      (progn (ros::ros-info "recog: ~A balls found!  ~%" (length (send msg :boxes)))
	     (setq *ball-xpos* (send (send (send (elt (send msg :boxes) 0) :pose) :position) :x))
	     (setq *ball-ypos* (send (send (send (elt (send msg :boxes) 0) :pose) :position) :y))
	     (setq *ball-zpos* (send (send (send (elt (send msg :boxes) 0) :pose) :position) :z))
	     ;;(ros::ros-info "ball: x-pos:~A y-pos:~A z-pos:~A" *ball-xpos* *ball-ypos* *ball-zpos*)
	     )
    (ros::ros-info "no ball found! ~%")
    )
  )

;;motion
(defun back-drive()
  (setq r1 #f(-29.5312 35.2688 -32.5687 54.54))
  (setq r2 #f(-29.1937 28.08 -12.7575 54.2363))
  (setq r3 #f(-34.56 15.9975 9.45001 55.215))
  (setq r4 #f(-30 7.15501 26.46 46.3725))
  (setq r5 #f(-30 7.15501 40.107 44.0775))
  (setq r6 #f(-70 28 -44 70))
  (setq tm 80)
  (send *ri* :angle-vector-sequence (list r1 r2 r3 r4 r5 r6) (list tm tm tm tm tm 1500)
	:default-controller 0.001
	:min-time 0.0001
	:minjerk-interpolation t
	)
  (send *ri* :wait-interpolation)
  (send *irtviewer* :draw-objects)
  )

;;音声系

;;;;;;;;;;;;;;;;;;;;;;;;;;;;;;;;;;;;;;;;;;;;;;;;;;;;;;;;;;;;;;;;;;;;;;;;;;;;;;;;;;;;;;;;;;;;;;;;;;;;;;;;;;;;;;;;;;;;;;;;;;;;;;;;;;;;;;;;;;;

;;main
(hari-init)
(on)
(setq *ball-lost* 1)
(wait-pose)
(search-ball)
(while (= *ball-lost* 1)
  (progn (search-ball)
	 (format t "aa")
  (setq *ball-xpos-tmp* *ball-xpos*)
  (setq *ball-ypos-tmp* *ball-ypos*)
  (setq *ball-zpos-tmp* *ball-zpos*)
  (format t "x: ~A, y: ~A, x: ~A~%" *ball-xpos-tmp* *ball-ypos-tmp* *ball-zpos-tmp*)
  (if (and (> *ball-xpos-tmp* 0.16) (< *ball-xpos-tmp* 0.20) (> *ball-ypos-tmp* -0.02) (< *ball-ypos-tmp* 0.02) (> *ball-zpos-tmp* -0.10) (< *ball-zpos-tmp* 0.10)) (setq *ball-lost* 0))
  (unix:usleep 10000))
  )
(back-drive)
(unix:sleep 3)

```

Michi-Tsubaki, 2024-12-14:
@iroy 先生に相談して勉強したこと．
### whileから抜け出せない件について
→そもそも`(ros::spin-once)`を正しく呼べていないのでsubできていなかった．

`(ros::subscribe "/detect_ball/cluster_decomposer/boxes" jsk_recognition_msgs::BoundingBoxArray #'search-ball-cb)`
でtopicが拾われるのではない．↑は，subしたいtopic名のQueryを登録しているだけ．よってこの登録はプログラム中のどこかに書いておけば良い．

実際に値を得るのは，`(ros::spin-once)`をしたときなので，`(search-ball)`と書いていたところ（subしてほしいところ）に(ros::spin-once) (or (ros::spin))を書くと所望の動作が得られる．
ただし，` (ros::spin)`は常時休まずsubしてしまうので，基本使わない．（イベントドリブンでsubしたいときには用途がない．）

### sleepについて
`(unix:usleep 10000)`は完全にプログラムを止めてしまうのでrosも落ちてしまうに対して，
`(ros:sleep)`は，`(ros::rate xx)`の周期は「回ったまま」，sleepする．
→pythonの`rospy.sleep`と`time.sleep`の違いと同様の扱い

### その他
`(send *ri* :servo-on)` した直後に`(send *ri* :angle-vector (send *robot* :angle-vector) 1000)` する場合は直前に`(unix:sleep 1)`とかを入れたほうが安定するらしい．0.2秒以上休まないと動かない．（by Aくん）

Michi-Tsubaki, 2024-12-14:
上記を踏まえて
https://github.com/Michi-Tsubaki/ping-pong-robot/blob/82991466a894d992b135313cd119744e16bde5ff/src/HARIMOTO/scripts/main.l
のcommitでバグは修正済み．本件issueはこれにて完了．

Closed 2024-12-14.

Thread 8 (2024-12-14):

車体・胴体の設計及び組み立て（完成版）

Michi-Tsubaki, 2024-12-14:
車輪（メカナム）をつけるのに合わせて，車体の最終verを設計．組み立てする．

前回の仮胴体を作ったときは中実でフィラメントをかなり無駄にしてしまったので，今回はできるだけ中空構造にして，パーツの再利用性も高める．

Michi-Tsubaki, 2024-12-14:
車体：　https://github.com/Michi-Tsubaki/ping-pong-robot/blob/main/model/parts/wheel_base.STL
胴体：　https://github.com/Michi-Tsubaki/ping-pong-robot/blob/main/model/parts/body_base.STL
胴体はかなり中空になった．
ただ，中空部分のサポート材を取るのに1時間以上かかってしまったので，サポートの取り出し口なども考えて設計するのがよいことがわかった！

Michi-Tsubaki, 2024-12-14:
正面
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

横から
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

下から
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

上から
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

Michi-Tsubaki, 2024-12-14:
モーターがつ付いた

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

Michi-Tsubaki, 2024-12-18:
車輪がついたので，本issueは完了！

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

Closed 2024-12-18.

Thread 9 (2024-12-16):

urdf modelの再構築（車輪・realsense込み）

Michi-Tsubaki, 2024-12-16:
車輪と車体も完成したことなので，urdfモデルを再作成してみる．solidworksは重くて動かないので，以下のGUIツールを使用してみる．
https://github.com/Michi-Tsubaki/urdf_kitchen

Michi-Tsubaki, 2024-12-20:
ホイールと胴体。

Michi-Tsubaki, 2025-01-09:
on Jan. 7th Done
・車輪の向きと位置をurdf上で正した
・車体の「車台(ベース)」と「本体(タワー)」をurdfでvisual追加．boxとして描画した(on rviz)
→これでロボットの全体がurdfに記述された．
・realsenseのcamera_linkの情報をHARIMOTOのurdfに加えた
→これによりロボットの運動とボールの位置情報がros上で同期！
→"camra_link"ではなく”base_link"ですべてを確認できるようになった．

以上で本commitは終了

Closed 2025-01-09.

Thread 10 (2024-12-17):

ボールの軌跡予測

Michi-Tsubaki, 2024-12-17:
falling-point-estimationを行う．

- https://qiita.com/otakoma/items/04216c60fa31eae60947 が参考になりそう．

Michi-Tsubaki, 2024-12-19:
Real senseのフレーム数を最大にする

Michi-Tsubaki, 2024-12-19:
私立園になくす

Michi-Tsubaki, 2024-12-20:
着地点予測するに時間も加える。打つタイミングを決める。

Michi-Tsubaki, 2024-12-20:
https://github.com/Michi-Tsubaki/ping-pong-robot/blob/main/src/HARIMOTO/scripts/falling-point-estimation.py
で作業中．

Michi-Tsubaki, 2024-12-22:
学科PCのストレージがなくなって警告が来たとき
` du -ah ./ | sort -rh | head -10`
で重いファイルが確認できる．不要そうなのを`rm -rf `コマンドで消す．

Michi-Tsubaki, 2024-12-23:
`rostopic hz ` 出力された結果のトピックの通信周波数を確認することができる．ボールの通信位置が90fpsでpubされているかをチェックすると良い by kojima先生

Michi-Tsubaki, 2025-01-09:
falling_estimation.pyは使用しない．で予測もmainで行う…
→https://github.com/Michi-Tsubaki/ping-pong-robot/issues/14

Closed 2025-01-09.

Thread 11 (2024-12-18):

メカナムを動かす

Michi-Tsubaki, 2024-12-18:
方法
①ICS変換基板を別で借りて，ROSシリアルで完全に独立制御する
②urdfとlaunchとservo_configを書き換えて白基板を使って，アームと一緒にminimal.launchとeusで制御する
　→ICS変換基板を借りるのがめんどくさいからとりあえず②でやる．

Michi-Tsubaki, 2024-12-20:
> 12/20 演習で質問する予定のこと

解決。

### 原因
- サーボの設定が「連続回転（rotation）モード」になっていなかったのが問題だった．

### 解決方法
- サーボIDの書き込みプロセスを行いモードを書き換えた

### わかったこと
- urdfのホイール部分は，jedyのコピペの適当なままで良かった．
- サーボの連続回転モードかどうかがjointのcontinuousとrevoluteと対応していて，違うと動かない．

Michi-Tsubaki, 2024-12-20:
minimal.launchで
mecanum_drive_controller.launch（https://github.com/Michi-Tsubaki/ping-pong-robot/blob/main/src/HARIMOTO/launch/mecanum_drive_controller.launch ）を指定した．

これで，ros_controlのridgeback_controlで横にも動ける！

Michi-Tsubaki, 2024-12-20:
上下左右動く

https://github.com/user-attachments/assets/2edb90ed-2776-49f5-a0a4-3e0bacae7ca6

Michi-Tsubaki, 2024-12-20:
↑これで本issueは完了．

Closed 2024-12-20.

Thread 13 (2025-01-05):

d435のdepthとcolorの両方で90fpsを実現して，ボールを打てるか確認する．

Michi-Tsubaki, 2025-01-05:

Michi-Tsubaki, 2025-01-09:
on Jan 7th
原因はusbケーブルがusb2.0だったことっぽい．矢野倉先生にUSB3.0のケーブルに交換していただいたことで，color depthともに60fpを実現した．もともと15fpsだったのでかなり良い！ 90fpsは不可能そうだが，60fpsで妥協してここからは予測性能を上げていく！

以上で本commitは終了

Closed 2025-01-09.

Thread 14 (2025-01-09):

制御アルゴリズム(=main)を本格化させる

Michi-Tsubaki, 2025-01-09:
以下の基本的な考えに基づき制御アルゴリズムに更新する．
＝＝＝＝＝＝＝＝＝＝＝＝＝＝＝＝＝＝＝＝＝＝＝＝＝
**1. プッシュ打ちとドライブ打ちの使い分け**
打ち方について：
・プッシュ打ち（＝温泉卓球打ち）
　メリット：しっかりと前に or 高く飛ばせる
　デメリット：重力に逆らってモータを駆動しなければならいないので，スピードがでない
・ドライブ打ち
　メリット：重力の落下加速度を運動に用いることができるのでスピードがでる
　デメリット：ボールを上にこすり打ち上げるのが難しく，地面に叩きつけてしまう

→各打ち方の初期姿勢（＝ロボット待機姿勢）をダイナミックに変えるのが難しいので，ボールによって打ち方を変えるのは困難である．ただ，どちらのデモも試みたい．（基本的にはプッシュ打ちモードを使うが，「魅せ方」的な意味で「ドライブ」打ちが必要だと思う．）

運用：
・起動時に手を上げていた場合は，「ドライブ打ちモード」
・手を下ろしていた場合は，「プッシュ打ちモード」
とする．

必要なタスク：
・現在のconfigurationの元でのプッシュ打ちとドライブ内の軌跡をもう少し細かくする，かつ，確定させる！
・ 高さ方向を引数にした関数についても，確定させる．
＝＝＝＝＝＝＝＝＝＝＝＝＝＝＝＝＝＝＝＝＝＝＝＝＝＝
**2. 予測アルゴリズムの改善**
★ボールの距離に応じて「near, middle, far」の3つのエリアを設定し，エリアごとに予測アルゴリズムを変える．
**nearのとき**

予測しない．『狭い』sweet spotの範囲にボールがある時，ボールを打つ．

**middleのとき**

(現在の実装の通り)『中くらいの』sweet spotにボールが来そうな場合，(予測時間-offset1)の時間後に打つようにする．
　＊瞬間速度を使う

**farのとき**

『広い』sweet spotの範囲にボールが入りそうなとき，ボールの着地地点に移動して，(予測時間-offset2)の時間後に打つようにする．
　＊余裕があるので平均速度を使う．

本件は，まずプッシュ打ちモードについて実装した後，ドライブ打ちモードについても実装する．
＝＝＝＝＝＝＝＝＝＝＝＝＝＝＝＝＝＝＝＝＝＝＝＝＝＝＝
**3. HSVカラーフィルタのパラメタチューニングをして特徴量の数を少なくする．（計算効率化）**

Michi-Tsubaki, 2025-01-09:
3. HSVカラーフィルターのチューニング終了
  <arg name="queue_size" default="4" /> ==>5から変更これで遅れが小さくなるはず
  <arg name="h_limit_max" default="15" doc="The maximum allowed field value Hue" />
  <arg name="h_limit_min" default="353" doc="The minimum allowed field value Hue" />
  <arg name="s_limit_max" default="255" doc="The maximum allowed field value Saturation" />
  <arg name="s_limit_min" default="100" doc="The minimum allowed field value Saturation" />
Sが重要で，0から100に変更することで，指が認識されなくなった．
  <arg name="v_limit_max" default="255" doc="The maximum allowed field value Value" />
  <arg name="v_limit_min" default="100" doc="The minimum allowed field value Value" />

Michi-Tsubaki, 2025-01-09:
TODO
FARに実装
予測を2つにわけるのを未実装
DRIVEのアルゴリズムの実装
打撃をもっとしっかりとする＊重要＊

Michi-Tsubaki, 2025-01-09:
ボールの軌道の二次関数フィッティングや、登る時下る時を場合分けした予測などにも挑戦！

Michi-Tsubaki, 2025-01-10:
予測のノイズ処理（フィルタ処理）が必要

Michi-Tsubaki, 2025-01-11:
Choreiと叫ぶ条件を厳しくした．

TODO
・打撃関数を洗練させる
・タイミングのパラメタ調整

★壊さない

Michi-Tsubaki, 2025-01-12:
現状
- 4回に1回くらい上手く打てる
- もうちょっと打撃を工夫したい
- チョレイの判定厳しすぎる

https://github.com/user-attachments/assets/104d6cf8-47b2-4fe5-8e7e-2837d7c343a8

Michi-Tsubaki, 2025-01-12:
Push hitの打撃完遂完成

Michi-Tsubaki, 2025-01-12:
Far内のMiddle処理にもmove followを実装せよ

Michi-Tsubaki, 2025-01-13:
↑追加した
他にもバグ修正した．https://github.com/Michi-Tsubaki/ping-pong-robot/pull/16

Michi-Tsubaki, 2025-01-13:
HARIMOTO好プレイ集

https://github.com/user-attachments/assets/58849984-7b79-49e7-ac35-15ba77b642aa

Closed 2025-01-13.

Thread 15 (2025-01-09):

「外側」の作成（ユニフォームとゼッケン，顔，ケース）

Michi-Tsubaki, 2025-01-09:
ユニフォーム・ゼッケン・顔・ケースをそれぞれ制作する．
ユニフォーム→服から
ゼッケン→印刷してゼッケンに縫い付ける
顔→紙粘土で造形
ケース→3Dプリンタで造形する．

Michi-Tsubaki, 2025-01-09:
腕をどのように隠すかor隠さないかも考える．

Michi-Tsubaki, 2025-01-09:
服完成！！

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

Michi-Tsubaki, 2025-01-11:
ブーツを作る！

medamawa, 2025-01-12:
ファイト！

Michi-Tsubaki, 2025-01-12:
靴、ラケット、カバー、右腕完成！

あとは顔だけ！

斜め前
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

正面
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

Michi-Tsubaki, 2025-01-12:
ロボット完成！！

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

Michi-Tsubaki, 2025-01-13:
ロゴ

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

Closed 2025-01-12.
